H-PS/esp32-remote-power-login/TECH_SUMMARY.md

# WiFi 远程开机 + PIN 自动登录器 · 技术总结

> 项目周期：约 2 天（2026-09-24 ~ 09-27）｜成本：¥28｜平台：ESP32-S3
> 作者：一名大二嵌入式学习者

---

## 一、项目要解决什么问题

**真实痛点**：人在外面，想远程用宿舍/家里的笔记本，但它处于**关机或锁屏**状态。

市面方案的死角：

| 场景 | 常见方案 | 为什么不行 |
|---|---|---|
| 笔记本已关机 | WOL 网络唤醒 | 关机后网卡断电，无线 WOL 基本失效；睡眠也可能因"风扇全关=网卡断电"而失败 |
| 已开机但锁屏 | ToDesk / 向日葵外设模拟、pynput、AutoHotkey | 登录界面运行在 **Secure Desktop（安全桌面）**上，会话还没建立，所有软件级按键注入**全部无效** |
| 已开机但锁屏 | ToDesk/向日葵"无人值守"模式 | ✅ 能用，但要装系统服务 + 商业软件 + 有隐私顾虑 |

**核心洞察**：Windows 登录屏只认**真键盘**。所以要在这个环节做自动化，必须用**硬件 HID 设备**——这正是 ESP32-S3 的强项（原生 USB-OTG，能把自己枚举成标准键盘）。

**方案定形**：

```
手机（任何有网的地方）
    ↓ MQTT（巴法云）
ESP32-S3 ── USB 线 ──→ 笔记本（被识别为 USB 键盘）
    │                       ↑ 自动键入 PIN 完成登录
    └── GPIO4 ──→ SG90 舵机 ──→ 物理按压电源键（解决"关机后无法软开机"）
```

一句话概括：**用一块 20 元的板子，同时扮演"键盘"和"手指"两个角色。**

---

## 二、硬件选型与接线

### 主板：YD-ESP32-S3 N16R8（约 ¥19.5）

选它的关键理由：

- **原生 USB-OTG 直连芯片**（不是接 CH340 之类的 USB 转串口芯片）→ 能枚举成 **USB HID 键盘**
- **双 Type-C 口**：`COM` 口（CH343P，烧录用）+ `USB/OTG` 口（运行时当键盘用）
- 16MB Flash / 8MB PSRAM，资源充裕

> ⚠️ **买板避坑**：一定要问客服"两个 Type-C 口是否都直连 S3 芯片"。若某个口走 CH340/CP2102 串口芯片，那个口**永远不可能变成键盘**。同理别买 ESP32-C3/C6（无 USB HID 能力）。

### 执行器：SG90 舵机（约 ¥5）

对比过三类执行器：

| | SG90 舵机（凸轮装法） | 微型电磁铁 ZYE1-P08/15 | JF-0530B 大电磁铁 |
|---|---|---|---|
| 末端力 | ~600g，但**匀速可中途停** | ~100g 瞬击 | ~700g 瞬击 ❌ 过猛 |
| 冲击 | 可调到比手指还轻 | 轻敲 | 砸键帽 |
| 失效模式 | 齿轮打滑=不动作（安全） | 断电回位 | 同左但冲击大 |
| 行程 | 角度任意可调 | 固定 2~3mm | 约 5mm |
| 持续按住 | 可以 | 不行（线圈发热） | 更不行 |

**最终选 SG90 + "凸轮装法"**：

- 不装外伸拨片（那是"横扫风险"的根源），把舵机圆盘**正对按键上方**，盘边缘当压头、贴一小块硅胶垫
- 转动只有一个**垂直自由度**，物理上不可能横扫
- 待机 `10°` 离开按键、按压 `95°` 压到底，压多深全由角度决定

> **安全原则**：真正危险的不是"舵机还是电磁铁"，而是**力远超按键需求 + 没有限位**。笔记本电源键只需 60~120g。

### 接线拓扑

```
5V 2A 充电头 ──Type-C──▶ ESP "COM" 口（供电，常年在线）
                          ├ 5V 排针 ──▶ 舵机红线
                          ├ GPIO4  ──▶ 舵机橙线（PWM 信号）
                          └ GND    ──▶ 舵机棕线（必须共地）
ESP "OTG" 口 ──Type-C 数据线──▶ 笔记本 USB 口（键盘信号）
```

- 舵机电源从 ESP 5V 排针取（板上有二极管，实际约 4.6V，SG90 轻负载够用）
- 按压瞬间约 800mA，充电头选 **5V/2A** 有余量
- **铁律：舵机 GND 必须和 ESP GND 连通**

---

## 三、软件架构

### 3.1 整体结构

单文件固件 `wifi_pin_login.ino`（约 460 行），四个模块：

```
┌─────────────────────────────────────────────────┐
│  ① 执行器层   pressPower()  舵机 PWM 驱动        │
│  ② 键盘层     typeString()  USB HID 键序控制      │
│  ③ 通信层     WebServer(80) + PubSubClient(9501) │
│  ④ 流程层     doLogin / doLogin1 / actionBoot    │
└─────────────────────────────────────────────────┘
```

### 3.2 双通道控制（互为备份）

| | 路线 A：局域网网页 | 路线 B：巴法云 MQTT |
|---|---|---|
| 前提 | 手机与 ESP 同一 WiFi | ESP 有公网 |
| 优点 | 零依赖、无云、延迟低 | **人在任何地方都能用** |
| 缺点 | 校园网客户端隔离会挡 | 依赖第三方云 |
| 载体 | ESP 上的 `WebServer(80)` | `bemfa.com:9501` |
| 鉴权 | URL 里带 `PAGE_TOKEN` 口令 | 巴法云私钥 uid |

两条通道共用同一批动作函数，互不干扰，可同时启用。

### 3.3 MQTT 协议要点（巴法云）

```cpp
mqtt.setServer("bemfa.com", 9501);   // MQTT设备云 端口
mqtt.connect(BEMFA_UID);             // ClientID = 私钥 uid，无需用户名密码
mqtt.setKeepAlive(15);               // 15s 心跳防"半开连接"
mqtt.subscribe(BEMFA_TOPIC);
```

**踩过的四个坑（很关键）**：

1. **命名必须在「新建主题」时一次填对，不要建完再改名** ⭐
   - 主题**名称**和**昵称**都要在创建弹窗里就写成最终值（如 `power003`）
   - ❌ 建的时候随手取名（`test` / `power001` / `风扇`），事后再改名
   - ✅ 直接在建的时候把名称和昵称都填 `power003`，一次到位
   - **为什么不能事后改**：巴法云要求 **昵称 == 主题名**；改名操作容易只改其中一个，一旦不一致就进入"伪在线"状态（见下），极难排查。**建错了就删掉重建，比改名可靠得多。**
2. **TCP设备云 ≠ MQTT设备云**，是**两个隔离空间**：
   - MQTT 协议(9501) 必须连 **MQTT 设备云**里的主题
   - TCP 协议(8344) 只认 **TCP 设备云**里的主题
   - 协议与主题所在空间不匹配 → ESP 报"连接成功已订阅"，但服务器显示"订阅者离线"+ 消息推不到（**伪在线**）
3. **主题类型决定能发什么消息**：
   - **开关型**主题只推送 `on` / `off`，自定义文本（如 `login` / `login1` / `test`）被服务器静默忽略
   - 要发自定义指令必须建 **消息型**（我们最终用 MQTT设备云 的消息型主题 `power003`）
4. **"伪在线"的本质**：坑 1 和坑 2 的表现完全一样 —— ESP 端 `mqtt.connect()` 返回成功、`subscribe()` 也返回成功，但巴法云后台显示"订阅者：离线"，发消息无任何反应。**排查时先查"名称/昵称是否一致 + 主题是否建在 MQTT设备云 + 类型是否消息型"这三项**，而不是怀疑代码。

### 3.4 ESP32-S3 的 GPIO19/20 双重身份

这块板子最反直觉的一点，但理解了就豁然开朗：

| 时机 | GPIO19/20 的角色 |
|---|---|
| 刚上电 / 烧录时 | ROM 里的 **USB-Serial-JTAG**（枚举成 COM 口） |
| 程序运行后 | **TinyUSB HID 键盘** |

**同一根线、同一个口，烧完自动变身。** 所以：
- 烧录时看得到 COM 口
- 程序跑起来后，Windows 设备管理器里出现"HID 键盘设备"

---

## 四、关键技术难点与解法

### 难点 1：Windows 安全桌面无法软件注入

**结论**：无解，必须硬件。这也是项目的**立项理由**。

ESP32-S3 用 Arduino 的 `USBHIDKeyboard` 库即可：
```cpp
#include "USBHIDKeyboard.h"
USBHIDKeyboard Keyboard;
Keyboard.begin();          // setup 里调用
Keyboard.write('0');       // 敲一个字符
```

**Arduino IDE 必设项（缺一不可）**：

| 设置项 | 值 | 为什么 |
|---|---|---|
| USB Mode | `USB-OTG (TinyUSB)` | **不选这个就不会被识别为键盘** |
| USB CDC On Boot | `Enabled` | 实测：Disabled 时 HID 不枚举 |
| Flash Size | `16MB (128Mb)` | 板子是 N16R8，默认 4MB 烧不进 |
| PSRAM | `OPI PSRAM` | 匹配硬件 |
| Partition | `16M Flash (3MB APP/9.9MB FATFS)` | 匹配 Flash 布局 |

### 难点 2：「PIN 多出两个 00」——一次教科书级的误判排查

**现象**：`login1` 能成功解锁，但输入的 PIN 从 `123456` 变成 `12345600`。

**排查路径（完整还原，含走过的弯路）**：

| 步骤 | 检查内容 | 结论 |
|---|---|---|
| ① | `PIN_CODE` 原始字节（`open(p,'rb')`） | ✅ 干净的 `"123456"`，无 BOM、无隐藏字符 |
| ② | 键盘布局映射表 `KeyboardLayout_en_US.cpp` | ✅ `'0'`→`0x27`、`'7'`→`0x24`、`'2'`→`0x1F`、`'1'`→`0x1E`、`'6'`→`0x23`，**全部不带 SHIFT**；`'\n'`(0x0A)→`0x28`(Enter) |
| ③ | 库源码 `USBHIDKeyboard.cpp` | 发现 `write(c)` = `press(c); release(c);`，**两个 HID 报文紧挨着发、零间隔** |
| ④ | 让 ESP 把内容打进**记事本** | 分离"发送端 vs 主机端" |

**最终真因**：**必应（Bing）搜索框的自动补全**。

测试时电脑**没锁屏**，焦点落在浏览器必应搜索框里。输入 `123456` 后搜索建议自动联想补全后缀，看起来就像"多打了 00"；再按回车触发的是搜索框而不是 PIN 提交。

**这个教训比 bug 本身更值钱**：

> **测试场景必须与设计场景一致。** 这个装置是为「锁屏」设计的，未锁屏测试会引入完全无关的变量。白排查了半天。

**顺带做的三处工程加固**（即使真因在主机侧，这些也都有独立价值）：

```cpp
// ① 替代裸 Keyboard.write()：避免 down/up 报文被主机合并成长按→触发 auto-repeat
void typeString(const char* s) {
  Keyboard.releaseAll();
  delay(60);
  for (const char* p = s; *p; p++) {
    Keyboard.press(*p);
    delay(KEY_HOLD_MS);      // 30ms：主机轮询来得及采样
    Keyboard.release(*p);
    delay(KEY_SETTLE_MS);    // 60ms：字符间隔，防合并/防联想补全
  }
  Keyboard.releaseAll();     // 防"黏键"
  Serial.printf("[Key] 已键入: \"%s\"\n", s);
}

// ② MQTT 消息去重：防手机端弱网重发把 PIN 打两遍
if (msg == lastMsg && (millis() - lastMsgAt) < MSG_DEDUP_MS) return;

// ③ 自检通道：把 PIN 打进记事本，一眼分辨问题在 ESP 还是主机
void typeSelfTest() { ... }
```

### 难点 3：校园网 Portal 的误判（最大的一次判断失误）

**背景**：ESP 要联网收 MQTT 指令，但校园网有深澜（srun）Portal 认证。

**初期判断**（错误）：HTTP 请求百度被劫持 → 外推为"整个外网被拦" → 于是花了大量精力做 srun 认证移植。

**实际做了什么**（技术上全对，但方向错了）：
- 逆向校园网深澜（srun）Portal 协议：三接口（`srun_portal_pc` → `get_challenge` → `srun_portal`）+ `xencode`(XXTEA 变体，魔数 `0x9E3779B9`) + **非标 base64** + MD5/SHA1
- 用 Python 复刻 C 逻辑 + 8 组用例逐字节对比官方 Python 版 → **全部一致 ✅**
- ESP 实测认证成功：`suc_msg: "login_ok"`

**真相**（用户测试数据揭示）：

```
HTTP   www.baidu.com:80        → 被劫持（返回 29KB 认证页）
MQTT   bemfa.com:9501          → ✅ TCP 连接成功
DNS    114.114.114.114:53      → ✅ 通
```

> **深澜 Portal 只劫持 HTTP 80 端口，其他端口一律放行。**
> **所以 ESP 根本不需要任何认证就能用 MQTT。**

**教训**：
> **不要从协议层的现象（HTTP 被劫持）外推到业务层的结论（MQTT 连不上）。**
> 应该一开始就**直接测 MQTT 端口**——一行 `WiFiClient.connect("bemfa.com", 9501)` 就能省掉两天弯路。

### 难点 4：睡眠唤醒的彻底失败（及时止损）

**尝试过的四条路**：

| 路线 | 结果 |
|---|---|
| USB Remote Wakeup（`tud_remote_wakeup()` + `USB.usbAttributes(0xA0)`） | ❌ 一碰 TinyUSB 栈就启动 panic（`xQueueSemaphoreTake` 断言 + USB 枚举全失） |
| 无线 WOL（WoWLAN，魔术包目标是无线网卡 MAC） | ❌ 睡眠时无线网卡被断电（"风扇全关"），没有承载唤醒的硬件 |
| **有线 WOL**（魔术包目标为有线网卡 MAC） | ❌ ESP 在校园 WiFi 的网段，笔记本在宿舍有线的另一个网段 —— **两个 VLAN**，受限广播 `255.255.255.255` 不被三层设备转发 |
| **改用「锁屏」代替「睡眠」** | ✅ 系统运行中，ESP 键盘全程在线，`login1` 一条指令搞定 |

**有线 WOL 的排查过程（PC 侧全部配置正确，仍然失败）**：

- `Get-NetAdapterPowerManagement` → `WakeOnMagicPacket = Enabled` ✅
- `powercfg /deviceenablewake` → 网卡出现在 `devicequery wake_armed` ✅
- 关闭快速启动（`powercfg /h off`）、系统支持 S3、`Get-NetAdapter` 显示链路 Up / 1 Gbps ✅
- 固件侧：有线 + 无线两个 MAC 各发 3 轮、全局广播 + 本子网广播 + 定向单播、端口 9 / 7 ✅
- **结论：跨 VLAN 时以上全部无效。这不是驱动问题，是拓扑问题 —— 先查拓扑。**

**最终场景定义**：
- Windows 睡眠设为**从不**（`powercfg /change standby-timeout-ac 0`），日常用 `Win+L` 锁屏
- 合盖动作设为"不采取任何操作"（否则合盖即睡眠）
- 关机场景才轮到舵机物理按压

> **工程判断**：所有路都堵死时，**重新定义问题**比死磕方案更有效（睡眠 → 锁屏）。
> **排查判断**：把"配置正确"和"链路可达"分开验证 —— 前者你说了算，后者网络说了算。

### 难点 5：「能出电」不等于「能给舵机供电」

**现象**：舵机接好后完全不动，板子本身无任何异常表现。

**排查**：先确认信号线正常（`GPIO14` 有 PWM 输出）、舵机完好，最后怀疑供电 —— 放大实拍 `5Vin` 附近，发现 `IN-OUT` 焊盘是**两个光秃秃的 0603 焊盘**（0Ω 出厂未焊）。

**原理**：`5Vin` 脚到板内 5V 有两条并联路径 ——

```
5Vin ──┬──[ D3 二极管 ]──▶ 5V   单向（外部→板内），约 0.3V 压降   ← 出厂已装
       └──[ 0Ω 电阻  ]──▶ 5V   双向直连、无压降（丝印 IN-OUT）    ← 出厂未焊
```

`D3` 是单向的，所以默认状态下 `5Vin` **只能作输入**，从它取不到电。这是典型的**安全失败模式**：什么都不烧，只是不动。

**厂商文档确认**：可以短接焊盘对外输出 5V；但同一段话也明确写着"直接从核心板取电会影响 ESP32 的稳定运行"。

**为什么最终不给舵机用这条路**：舵机堵转 700 mA ~ 1 A，电流需行经

```
充电头 → USB线 → D1二极管(0.3~0.5V 压降) → 板内5V铜箔 → 5Vin → 舵机
```

按 `ΔV = I × R` 会把板内 5V 拉低 → ESP 触发 brownout 复位；而**若复位恰好发生在 600 ms 按压窗口内**，舵机会在按压途中失去 PWM、僵在电源键上，ESP 重启并归位要 3~5 秒 —— 正好撞上多数笔记本强制关机的临界时间。**想让它开机，结果把它关机了。**

**正解**：舵机走独立 5V（从充电头直引），只与板子**共地**；`IN-OUT` 焊盘留给小负载（<100 mA）。

> **可迁移经验**：
> 1. "排针应该有电"是个默认假设，**必须实测**。厂商把这个脚默认断开，本身就是在提示"别从这里取大电流"。
> 2. 评估供电不能只看"能不能出电"，要算**电流路径上的等效电阻**，以及**复位时机带来的机械后果**。

---

## 五、完整指令表

| MQTT 消息 | 网页按钮 | 路由 | 动作 |
|---|---|---|---|
| `on` | 开机并自动登录 | `/servologin` | 舵机按电源键 → 等 40s → 完整登录流程 |
| `off` | 只开机 | `/servopower` | 只按电源键 |
| `login` | 键入 PIN（完整流程） | `/login` | WOL + ESC + 回车 + PIN + 回车 |
| `login1` | 仅键入 PIN | `/login1` | 只打 PIN + 回车（**最稳，日常首选**） |
| `test` | 打字自检 | `/test` | 5s 后把 PIN 打进记事本（排障） |

### 场景选择决策表

| 场景 | 用哪个 | 原因 |
|---|---|---|
| **锁屏**（Win+L，最常用） | `login1` | PIN 框本身聚焦，最快最稳，不误触 |
| **屏幕已关**（系统仍在运行） | `login` | 需要 ESC 点亮 + 回车聚焦 |
| **已解锁，焦点在浏览器** | `login1` 或 `LOGIN_SEND_PREAMBLE=0` | ESC/回车会误操作 |
| ~~睡眠 / 休眠~~ | ❌ **无解** | 见「难点 4」—— ESP 唤不醒它，所以必须禁止自动睡眠 |

> **一句话**：不确定就发 `login1`——只做"打 PIN + 回车"，任何场景都不会帮倒忙。

---

## 六、关键参数速查（固件顶部）

| 常量 | 值 | 说明 |
|---|---|---|
| `WIFI_SSID` / `WIFI_PASS` | `YourWiFi` / `""` | 开放网络留空 |
| `PIN_CODE` | `123456` | Windows 登录 PIN |
| `PAGE_TOKEN` | `change_me` | 局域网网页口令 |
| `BEMFA_UID` / `BEMFA_TOPIC` | 你的私钥 / `your_topic` | 巴法云 MQTT |
| `PC_MAC` | `aabbccddeeff` | 笔记本网卡 MAC（WOL 用） |
| `ACT_PIN` | `4` | 舵机信号线 |
| `SERVO_IDLE_DEG` / `SERVO_PRESS_DEG` | `10` / `95` | 待机/按压角度 |
| `PRESS_HOLD_MS` | `600` | 按压保持时长 |
| `BOOT_WAIT_MS` | `40000` | 开机后等多久开始打 PIN |
| `KEY_HOLD_MS` / `KEY_SETTLE_MS` | `30` / `60` | 按键节奏 |
| `LOGIN_SEND_PREAMBLE` | `1` | `login` 是否发前置 ESC+回车 |
| `MSG_DEDUP_MS` | `3000` | MQTT 消息去重时间窗 |

---

## 七、踩坑清单（可复用的经验）

### Arduino IDE 相关

1. **一个工程目录只能有一个 `.ino` 主文件**——IDE 把同文件夹所有 `.ino` 合并成一个编译单元，放两个 `setup()` 必冲突
2. **文件夹名必须 == 主 `.ino` 文件名**，否则反复弹"移动文件"窗
3. **板子设置（工具菜单）不跨工程共享**——换工程就全回默认值。（规避：复制旧工程文件夹改名，别在 IDE 里新建）
4. **打开方式**：用「文件→打开→选 `.ino`」，别用「打开文件夹」

### 硬件相关

5. **双 Type-C 口的用途别搞反**：`COM` 口烧录、`OTG` 口当键盘。烧录失败/端口消失时换另一个口试
6. `USB CDC On Boot` 实测**必须 `Enabled`**，Disabled 时 HID 不枚举（网上有些旧教程写反了）
7. TCP 诊断：`g++` 不可用时，用 Python 状态机做括号配对自检（跳过注释/字符串/字符字面量，还要跳过 emoji 和全角引号）

### 协议相关

8. **`rad_user_info` 接口会撒谎**——未认证设备也返回 HTTP 200。判在线必须查 `user_name` 字段
9. **判断"是否被 Portal 劫持"不能只看域名关键字**——深澜劫持页里恰好也含 "baidu" 字样。要看 Portal 认证页的特征词（`入网须知` / `srun_portal` / 页内的内网网关地址）或页面体量（~29KB）
10. **巴法云：名称/昵称必须在「新建主题」时一次填对**——事后改名容易只改一个，导致昵称≠主题名 → "伪在线"
11. **巴法云协议与主题空间必须配对**（MQTT 9501 ↔ MQTT设备云；TCP 8344 ↔ TCP设备云，见 3.3）
12. **巴法云主题类型必须选「消息型」**——开关型只推 `on`/`off`，自定义指令被静默忽略
13. **`ip_already_online_error` ≠ 真能上网**——该 IP 的会话可能属于别的设备

### 方法论

14. **🎯 测试场景必须与设计场景一致**（PIN 那个坑）
15. **🎯 不要从协议层现象外推业务层结论**（Portal 那个坑）
16. **🎯 排障先做「二分」**：让设备把内容打进记事本，一眼分离发送端/主机端
17. **三条路都堵死时，重新定义问题**（睡眠 → 锁屏）

---

## 八、项目成果

### 技术指标

| 项 | 值 |
|---|---|
| 硬件成本 | **¥28**（板 19.5 + 舵机 ~5 + 纳米胶 3） |
| 开发周期 | **约 2 天** |
| 固件规模 | ~460 行 C++ / 19.5 KB |
| 响应延迟 | `login1` 约 0.5 秒；`on` 约 40 秒（等系统启动） |
| 控制距离 | **无限**（MQTT 云端） / 局域网内（网页） |

### 掌握的知识点

- **嵌入式**：ESP32-S3 USB-OTG / TinyUSB HID 设备开发、PWM 舵机控制、GPIO 双重身份、非阻塞网络编程（WiFi 重连 + MQTT 心跳）
- **网络协议**：MQTT 协议与客户端实现、HTTP/WebServer、WOL 魔术包、Portal 认证机制
- **安全/加密**：XXTEA 变体算法、非标准 base64、MD5/SHA1 链路、逆向工程方法论
- **工程方法**：二分排障、协议对比验证（Python 复刻 + 逐字节比对）、场景重定义、先备份再改动

### 可延伸方向

- 换成 ESP32-CAM：加一张"开机后屏幕截图"回传，确认登录成功
- 加 PID/编码器：把舵机换成带反馈的执行器，按压深度闭环控制
- 抽象成通用框架：`actuator + hid + cloud` 三层解耦，可复用于其他远程物理操作场景

---

## 九、文件清单

```
.
├── wifi_pin_login.ino    主固件（约 470 行）
├── README.md             使用文档（英文）
├── TECH_SUMMARY.md       本文
├── secrets.h.example     凭据模板（复制成 secrets.h 填真实值）
├── LICENSE               MIT
├── .gitignore            排除 secrets.h / 构建产物
└── power_bridge.scad     3D 打印一体化外壳（OpenSCAD 参数化）
```

> 另有校园网 Portal 认证的独立测试工程（加密算法实现 + 校验脚本），
> 与主项目解耦，**未随本仓库发布**。

---

*文档版本：v5.0 ｜ 最后更新：2026-09-27*
