H-PS/esp32-remote-power-login/(commit log)

2026-09-27 Initial release: ESP32-S3 remote power-on + PIN auto-login
    [power_bridge.scad]
2026-09-27 docs: add Chinese README (README.zh-CN.md) and language switcher
2026-09-28 feat: v5.4 - ENABLE_WOL switch, plus docs for the 5Vin trap and the VLAN limitation
    firmware
    - sync to v5.4: servo signal on GPIO14, dual-MAC WoL, WoL gated behind ENABLE_WOL
    - ENABLE_WOL=0 drops WoL from the build entirely (no WiFiUdp, no 3s stall in login)
    docs
    - new section: the 5Vin header pin is NOT live by default (D3 diode vs 0 ohm IN-OUT pad),
    including the vendor note and the supply-path / brownout analysis
    - rewrite 'Why not Wake-on-LAN?': the real failure was a VLAN boundary, not a driver
    - recommend lock screen over sleep, with the powercfg commands and the state table
    secrets
    - secrets.h.example: add SECRET_PC_MAC2 / SECRET_PC_IP
    [wifi_pin_login.ino]
